Zhopper/bayan_nano/readme.txt

Проект MIDI системы на основе платы Arduino Nano
Папки:
DOCS - всевозможная информация
PARTS - документация на различные компоненты системы
SOFT - программная часть, Midi_Bayan это папка скетча для arduino
