Zhopper/bayan_nano/(commit log)

2017-04-08 Самое начало
2017-04-09 Добавлена возможность загрузки и сохранения настроек
2017-04-09 Обновлена инструкция
2017-04-09 Добавлено звучание ноты при выборе инструмента и задании громкости
2017-04-09 Добавлена возможность звучания по двум каналам одновременно
2017-04-17 Добавлено выключение нот при нажатии и отпускании кнопки "Режим" Опытная кнопка _EP с функцией Pitch
2017-10-14 Добавлен датчик давления.
2017-10-15 Добавлена документация на датчик давления. Дописано руководство по сборке.
